epearsoe/Coleco-ADAM-SD-DDP/Images/IMG_1253.jpg

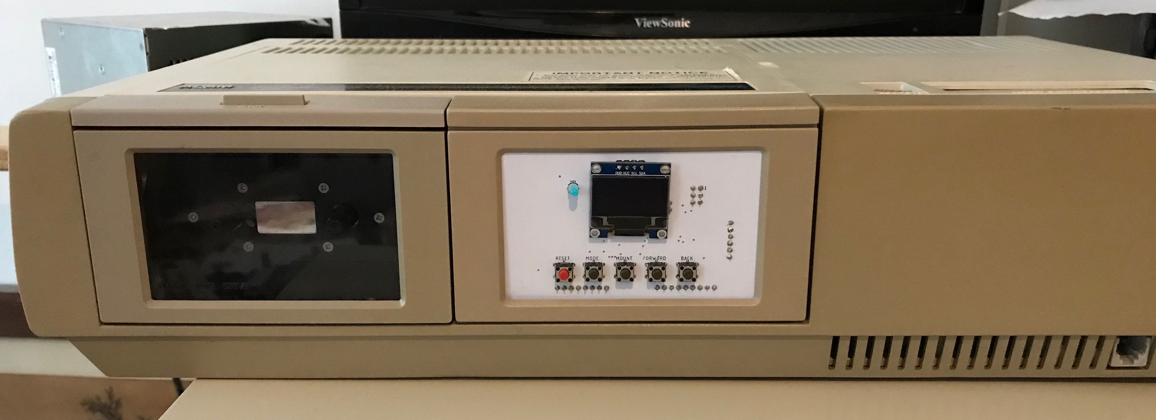
Images/IMG_1253.jpg
