epearsoe/Coleco-ADAM-SD-DDP/Images/IMG_1247.jpg

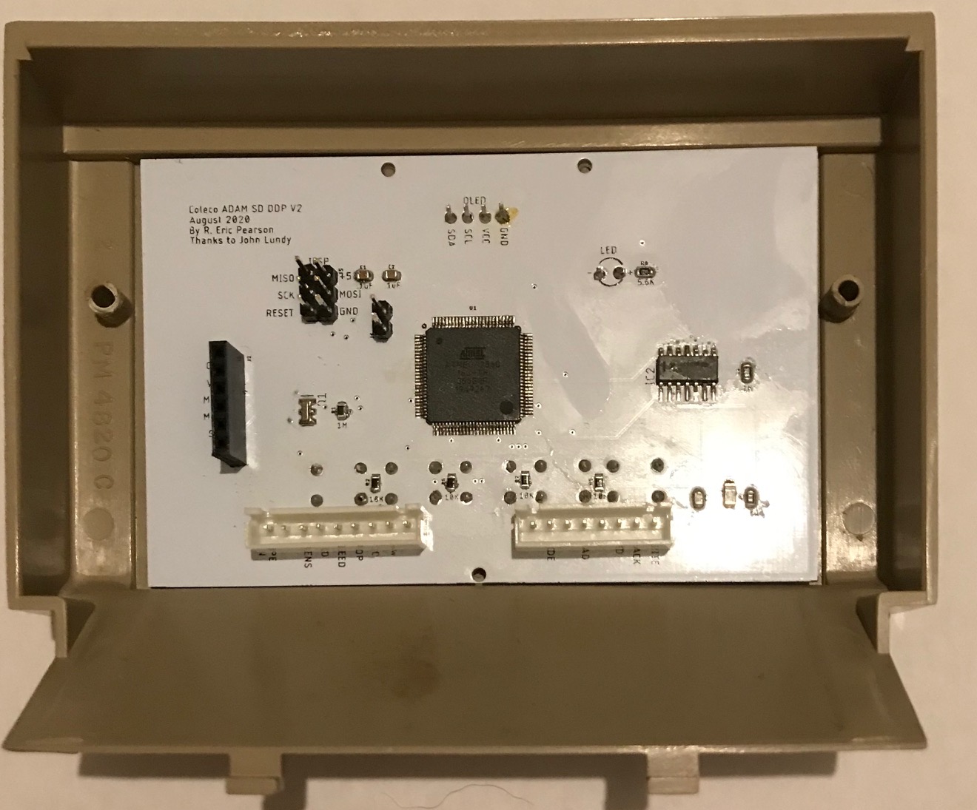
Images/IMG_1247.jpg
