epearsoe/Coleco-ADAM-SD-DDP/Deinterleave and Interleave.pdf

Deinterleave.exe – Converts an interleaved ADAM image to a deinterleaved ADAM image.

Interleave.exe – Converts an ADAM image to an interleaved ADAM image.

NOTE: File size is left unchanged. If you convert a 256K deinterleaved image, the interleaved image will also be 256K.

Deinterleave instructions:

1. Press “Select File” button to select an ADAM image.

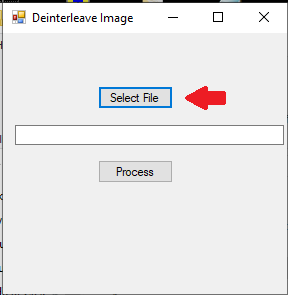
[picture p6: figure]

2. The image name selected is displayed in the text box.

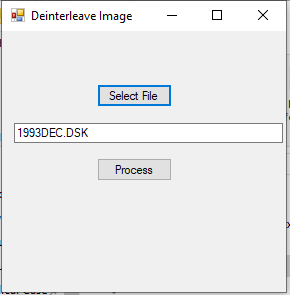
[picture p7: figure]

3. Press the “Process” button to deinterleave the selected image.

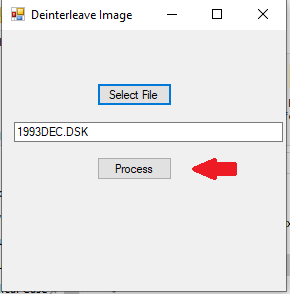
[picture p8: figure]

4. The converted file is created in the same directory with the filename: deinterleave_<selected filename>

Interleave instructions:

1. Press “Select File” button to select an ADAM image.

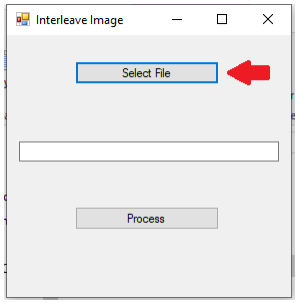
[picture p9: figure]

2. The image name selected is displayed in the text box.

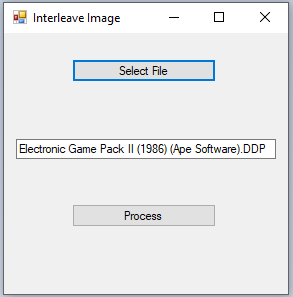
[picture p10: figure]

3. Press the “Process” button to interleave the selected image.

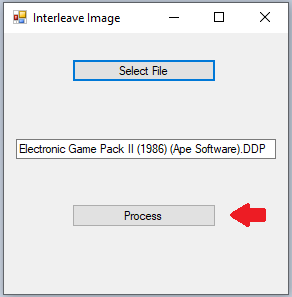
[picture p11: figure]

4. The converted file is created in the same directory with the filename:

interleave_<selected filename>
