epearsoe/Coleco-ADAM-SD-DDP/Images/IMG_1245.jpg

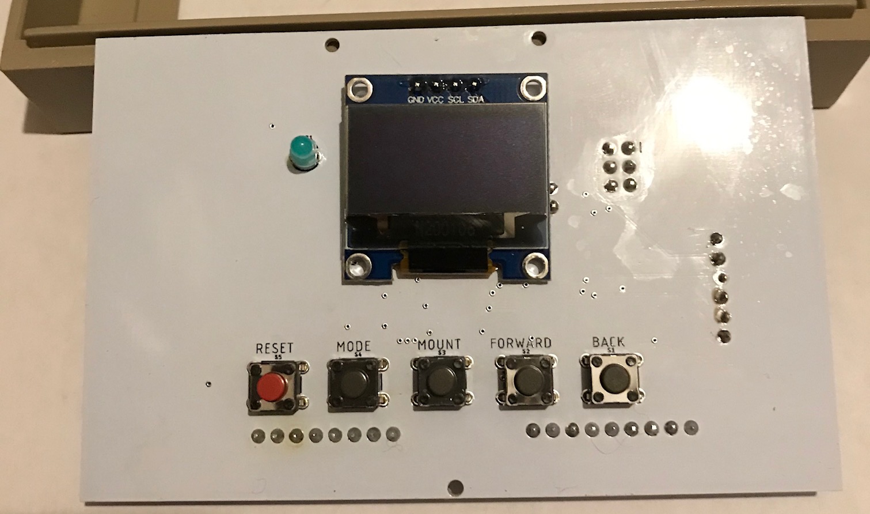
Images/IMG_1245.jpg
