epearsoe/Coleco-ADAM-SD-DDP/Images/IMG_1246.jpg

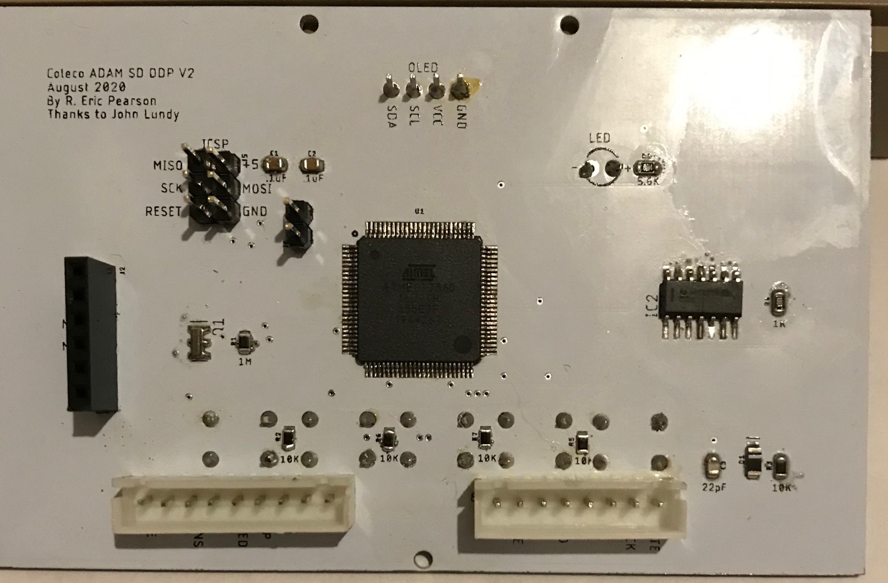
Images/IMG_1246.jpg
