epearsoe/Coleco-ADAM-SD-DDP/Images/IMG_1252.jpg

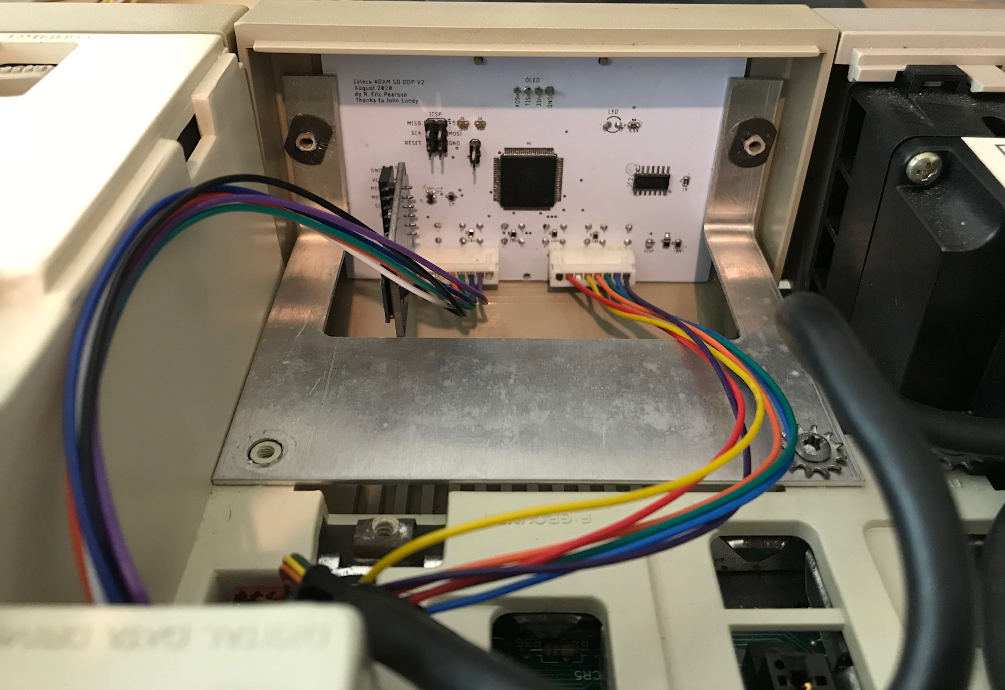
Images/IMG_1252.jpg
