epearsoe/Coleco-ADAM-SD-DDP/Images/IMG_1254.jpg

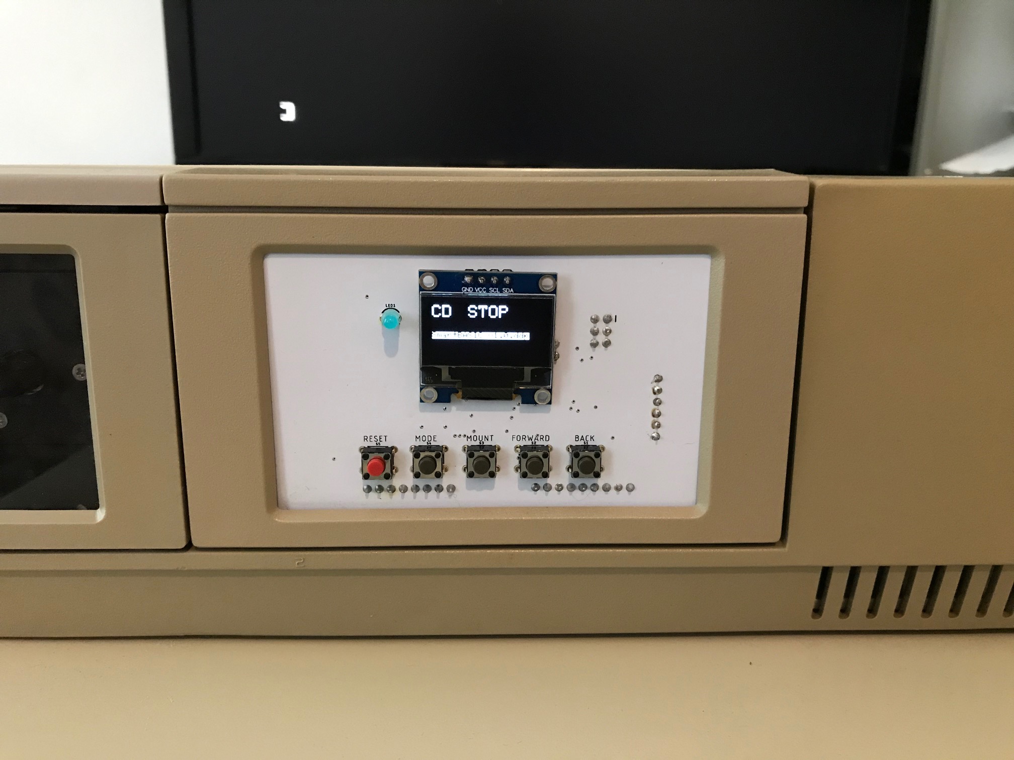
Images/IMG_1254.jpg
