epearsoe/Coleco-ADAM-SD-DDP/Bill of Materials.xlsx

Coleco ADAM SD DDP V3 Bill of Materials
Description | PCB Reference | Part Number | Vendor | Quantity Required | Approx Cost Per Unit (2020)
ATMEGA2560AU | IC1 | 556-ATMEGA2560-16AU | mouser.com | 1 | $11.85
SN74LS06N Hex Inverter HI-Z | IC2 | 595-SN74LS06D | mouser.com | 1 | $0.99
16MHz Resonator | Q1 | 81-CSTNE16M0V530000R | mouser.com | 1 | $0.29
.1uF Capacitor | C1,C2 | 80-C0805X104K5R3316 | mouser.com | 2 | $0.37
22pF Capacitor | C3 | 80-C0805X220K3GAUTO | mouser.com | 1 | $0.38
1M Resistor | R1 | 660-RN73R2ATD1004D25 | mouser.com | 1 | $0.39
10K Resistor | R2,R3,R5,R6,R7 | 660-RN73R2ATD1002D25 | mouser.com | 5 | $0.39
1K Resistor | R4 | 660-RN73R2ATD1001D25 | mouser.com | 1 | $0.39
5.6K Resistor | R8 | 667-ERJ-6RBD5601V | mouser.com | 1 | $0.14
Blue Diffused LED | LED1 | 593-VAOL-3LSBY2 | mouser.com | 1 | $0.64
Diode | D1 | 652-CD1206-S01575 | mouser.com | 1 | $0.15
Tac Switch Black | S1,S2,S3,S4 | 688-SKHHAM | mouser.com | 4 | $0.25
Tac Switch Red | S5 | 688-SKHHAR | mouser.com | 1 | $0.25
0.96 OLED LCD Display I2C IIC 128x64 | OLED |  | eBay.com | 1 | $3.00
Micro SD reader | MICROSD |  | eBay.com | 1 | $2.00
JST Connector 9 pin female to 9 pin female | J4 |  | eBay.com | 1 | Price varies. You can buy
JST Connector 9 pin male | J4 |  | eBay.com | 1 | pre-wired connectors off
JST Connector 8 pin female to 8 pin female | J3 |  | eBay.com | 1 | eBay or assortment kits and
JST Connector 8 pin male | J3 |  | eBay.com | 1 | wire them yourself.
2.54mm Female Header Socket Row Strip 6 pin | MICROSD |  | eBay.com | 1 | $1.45
40pin Single Row Male Header .100" (2.54mm) | ICSP Header, PIN2/3 Header, OLED Power Select |  | eBay.com | 1 | $0.50
2 (1 x 2) Position Shunt Connector Black Open Top 0.100" (2.54mm) Gold | OLED Power Select | S9337-ND | digikey.com | 2 | $0.10
