epearsoe/Coleco-ADAM-SD-DDP/(threads)

Thread 1 (2020-01-08):

SD DDP prevents a real physical DDP drive connected in second port to function

JohnLundy, 2020-01-08:
SD DDP prevents a real physical DDP drive connected in second port to function. Real DDP drive is recognized but when used it will start to spin forward at slow speed and until the end of tape is reached, followed by high speed rewind and repeats this over and over. The console needs to be powered down in order to get the drive to ever stop.

Troubleshooting done to determine this. Two physical DDP drives tested in second port would not function. It was found that removing the SD DDP will allow both physical DDP drives to function perfectly.

epearsoe, 2020-01-13:
Investigating this issue. The latest version of the code should prevent the SD DDP (as drive 0) from moving if a physical DDP (as drive 1) is in motion. From looking at the Technical Manual and the schematics from the DDP drive this might require additional circuitry to fix and I would welcome comments. From the Tech Manual it says "STOP - Prevents tape motion and latches data drive output to Logic 1 when at Logic 1 (active high). Enables data drive output and tape motion when at Logic 0."  If you look at the DDP schematic it looks like when the signal for STOP if HIGH it activates a transistor Q3.  Right mid-section of schematic. I'm wondering if this transistor needs to be added to the Arduino DATA out line at pin 18. I've tried manipulating the port through software with no success.
[Schematic Read-Write (color).pdf](https://github.com/epearsoe/Coleco-ADAM-SD-DDP/files/4056436/Schematic.Read-Write.color.pdf)

JohnLundy, 2020-01-14:
Taking a look at Q3, it appears to force the DATA OUT high when active. So, whenever STOP is low the DATA OUT is in a ‘normal’ state as Q3 is turned off. When STOP is not low, Q3 turns on holding the input of U2 (inverter) low, which causes the DATA OUT to be forced high the whole duration STOP is high.

STOP 0 = DATA OUT normal
STOP 1 = DATA OUT forced high

Seems like this should be able to be accomplished without the need of extra hardware.

epearsoe, 2020-01-14:
You would think. I've tried bringing DATA OUT high on STOP but it didn't make any noticeable difference. If I start with DATA OUT as an INPUT, INPUT_PULLUP and set it that way on BRAKE OR STOP and set it to OUTPUT only when sending data I get a strange behavior.  Using File Manager If I access a physical DDP in drive 1 it will work fine. If I switch to the SD DDP in drive 0 I will get a 'Not an EOS Media'.  If I try again on the SD DDP it will work fine.  Then if I go back to physcial DDP I will get a "Not an EOS Media".  Then it will work fine.  Same happens in reverse.

JohnLundy, 2020-06-01:
Version 1.3
 -  Changed virtual disk format from GW to HE which now allows for the SD DDP to work with a real DDP.
-  Successful block copy from real DDP with both left and center directory format to SD DDP
-  Added SN74LS7406N to ensure HI-Z state when SD DDP is stopped

Closed 2020-06-01.

Thread 2 (2020-01-08):

Booting the SD DDP without an SD card will lock on the boot splash screen

JohnLundy, 2020-01-08:
Booting the SD DDP without an SD card will lock on the boot splash screen. It would be nice to have an error message appear on the display when an SD card is not inserted and would possibly help troubleshoot a bad SD card or connection/hardware issues for users.

epearsoe, 2020-01-13:
This should be fixed in version 1.1.  It wasn't actually locking up. It was displaying "No SD Card" but I had forgotten to set the text color to white so it was printing black on black. The new version should display the message now and give you the option to insert an SD card and press the 'Mount' button to reinit the SD card.

Closed 2020-01-13.

Thread 3 (2022-02-19):

SD DDP Seems to be Holding Down the Ability for a Physical DDP to FF or RR

shawnmerrick, 2022-02-19:
Hello Eric,

Encountered this issue copying from source SD-DDP2 center directory image to destination physical DDP1 with center directory tape.

Use any EOS or CP/M SD-DDP image and a blank center directory tape.  Boot File Manager v3 (from ADE D1), TURN OFF expansion RAM in File Manager menu.  Select MEDIA FUNCTION, COPY BLOCKS.  Source TAPE B, SD-DDP2, start at 0, 256 blocks.  Dest physical TAPE A, DDP1, start block 0.

Reading source into buffer OK up to 33 blocks.  First attempt writing to physical DDP1 then loses it's mind slowly seeking endlessly.  Works perfectly when both DDP are physical drives.

Tested repeatedly and confirmed findings with another person.  SD DDP seems to be holding down the ability for the physical DDP to FF or RR.

Love this project 100%.  Just awesome for the community.  THANK YOU!

     Shawn Merrick
     shawnmerrick@hotmail.com

JohnLundy, 2022-02-20:
I’m also able to duplicate the issue. I’ve always utilized RAM expansion (256K or higher) while using FM3 and never noticed this. It appears the problem is whenever RAM expansion is not used and can’t completely read in the whole tape data in and then completely write it to physical media. Without having expansion RAM, the SD DDP is interfering with the ability for the physical drive to FF or RR, not sure which one or possibly both during the copy process. When this issue occurs, the SD DDP displays “stop98” and nothing else. Interestingly, a way I discovered to get it past this point is to hit the reset button on the SD DDP while FM3 is trying to write to the physical tape followed by mounting the same image being copied again. It will then do the same problem again, displaying “stop” and a block number again and doing the same reset process over and over until a full copy is made. It doesn’t appear to be releasing itself correctly like it does when a complete copy to RAM is performed. I hope this helps explain it in greater detail.

epearsoe, 2022-02-28:
Verified the issue and resolved in SD DDP firmware version 1.6.  Fix verified by John Lundy.  Following the instructions in "Bootloading and Programming the ATMEGA2560.pdf" under "SD DDP Programming Instructions" using the ADAM_DDP_SD_Drive_Int_Power_1_6.ino.hex to update your SD DDP.

Closed 2022-02-28.
