epearsoe/Coleco-ADAM-SD-DDP/Adafruit_SSD1306/splash.h

#define splash1_width  124
#define splash1_height 62

const uint8_t PROGMEM splash1_data[] = {
0x00, 0x00, 0x00, 0x00, 0x00, 0x00, 0x00, 0x00, 0x00, 0x00, 0x00, 0x00, 0x00, 0x00, 0x00, 0x00,
0x00, 0x00, 0x00, 0x00, 0x00, 0x00, 0x00, 0x00, 0x00, 0x00, 0x00, 0x00, 0x00, 0x00, 0x00, 0x00,
0x00, 0x00, 0x00, 0x00, 0x00, 0x00, 0x00, 0x00, 0x00, 0x00, 0x00, 0x00, 0x00, 0x00, 0x00, 0x00,
0x00, 0x00, 0x00, 0x00, 0x00, 0x00, 0x00, 0x00, 0x00, 0x00, 0x00, 0x00, 0x00, 0x00, 0x00, 0x00,
0x00, 0x00, 0x00, 0x00, 0x00, 0x00, 0x00, 0x00, 0x00, 0x00, 0x00, 0x00, 0x00, 0x00, 0x00, 0x00,
0x00, 0x00, 0x00, 0x00, 0x00, 0x00, 0x00, 0x00, 0x00, 0x00, 0x00, 0x00, 0x00, 0x00, 0x00, 0x00,
0x00, 0x00, 0x00, 0x00, 0x00, 0x00, 0x00, 0x00, 0x00, 0x00, 0x00, 0x00, 0x00, 0x00, 0x00, 0x00,
0x00, 0x00, 0x00, 0x00, 0x00, 0x00, 0x00, 0x00, 0x00, 0x00, 0x00, 0x00, 0x00, 0x00, 0x00, 0xE8,
0x00, 0x00, 0x00, 0x00, 0x00, 0x00, 0x00, 0x00, 0x00, 0x00, 0x00, 0x00, 0x00, 0x00, 0x00, 0x38,
0x00, 0x00, 0x00, 0x00, 0x00, 0x00, 0x00, 0x00, 0x00, 0x00, 0x00, 0x00, 0x00, 0x00, 0x00, 0x28,
0x00, 0x00, 0x00, 0x00, 0x00, 0x00, 0x00, 0x00, 0x00, 0x00, 0x00, 0x00, 0x00, 0x00, 0x00, 0x28,
0x00, 0x7F, 0xFE, 0x00, 0x1F, 0xFF, 0xFE, 0x00, 0x3F, 0xFF, 0x00, 0x0F, 0xF8, 0x00, 0x3F, 0x00,
0x00, 0x7F, 0xFE, 0x00, 0x1F, 0xFF, 0xFF, 0x80, 0x3F, 0xFF, 0x00, 0x0F, 0xF8, 0x00, 0x3F, 0x00,
0x00, 0xFF, 0xFF, 0x00, 0x3F, 0xFF, 0xFF, 0x80, 0x7F, 0xFF, 0x80, 0x1F, 0xF8, 0x00, 0x7F, 0x00,
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
  0x8D, 0x18, 0xE0, 0x00, 0x00, 0x1F, 0x00, 0x7F, 0xFF, 0xFF, 0xFF, 0xFE,
  0x95, 0xAD, 0x7D, 0xB5, 0x77, 0xE0, 0x00, 0x00, 0x0F, 0x00, 0x7F, 0xFF,
  0xFF, 0xFF, 0xFE, 0xA5, 0xAD, 0x9D, 0x8D, 0x19, 0xE0, 0x00, 0x00, 0x06,
  0x00, 0x7F, 0xFF, 0xFF, 0xFF, 0xFE, 0xB5, 0xAD, 0xED, 0xB5, 0x7E, 0xE0 };
